tarampampam/arduino-elscooter-lighting/arduino-elscooter-lighting.ino

#include "IO.h"
#include "TurningLights.h"
#include "StopSignal.h"
#include "DRL.h"
#include "PWM.h"

InputSwitch leftTurningButton(2);  // phisical pin #5
InputSwitch rightTurningButton(3); // phisical pin #6
InputSwitch stopSignalButton(4);   // phisical pin #7
InputSwitch drlSwitch(5);          // phisical pin #8
OutputKey backDrlKey(8);           // phisical pin #11
OutputKey frontDrlKey(9);          // phisical pin #12
OutputKey stopSignalKey(10);       // phisical pin #13
OutputKey leftTurningKey(11);      // phisical pin #14
OutputKey rightTurningKey(12);     // phisical pin #15

TurningLights turnings(&leftTurningButton, &rightTurningButton, &leftTurningKey, &rightTurningKey);
StopSignal stopSignal(&stopSignalButton, &stopSignalKey);
DRL drl(&drlSwitch, &stopSignalButton, &frontDrlKey, &backDrlKey);

void setup()
{
  leftTurningButton.init();
  rightTurningButton.init();
  stopSignalButton.init();
  drlSwitch.init();
  backDrlKey.init();
  frontDrlKey.init();
  stopSignalKey.init();
  leftTurningKey.init();
  rightTurningKey.init();

  drl.init();
}

void loop()
{
  unsigned long currentTimeMicros = micros();

  turnings.tick(currentTimeMicros);
  stopSignal.tick(currentTimeMicros);
  drl.tick(currentTimeMicros);
}
