tarampampam/arduino-elscooter-lighting/(commit log)

2021-06-29 Circuit updated
2021-07-06 Five clicks on stop signal button enables DRL lights
